KNITPhoenix/Self-sustainable-alert-device/circuit.PNG

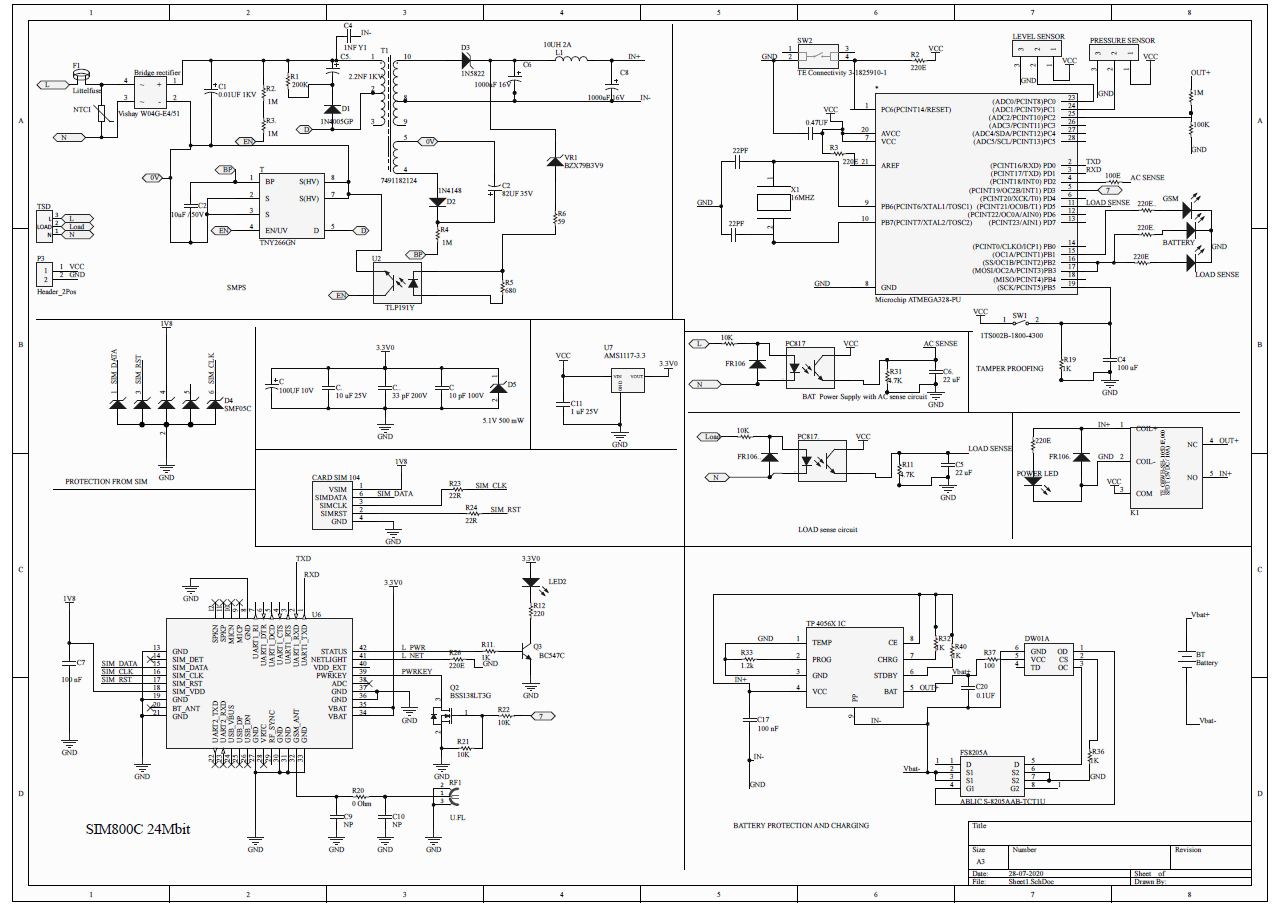
circuit.PNG
