KNITPhoenix/Self-sustainable-alert-device/PCB_design.jpeg

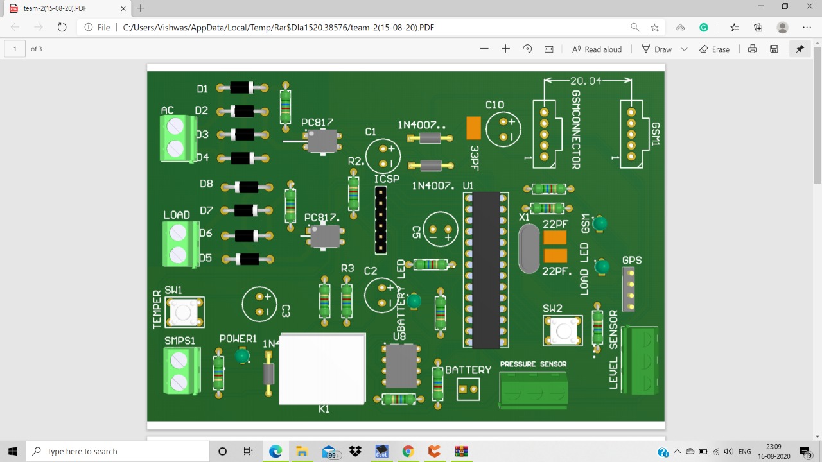
PCB_design.jpeg
